97hackbrian/Sensor_Proximidad_difuso/README.md

# Sensor_Proximidad_difuso
IMT-247 INSTRUMENTACIÓN INDUSTRIAL [Par. 1]
[Artículo](Proyecto_SensorDifuso_IEEE.pdf) o 
https://storage.googleapis.com/perritofeliz/Proyecto_SensorDifuso_IEEE.pdf
