97hackbrian/Sensor_Proximidad_difuso/Proyecto_SensorDifuso_IEEE.pdf

## Facultad de Ingeniería Semestre I-2023

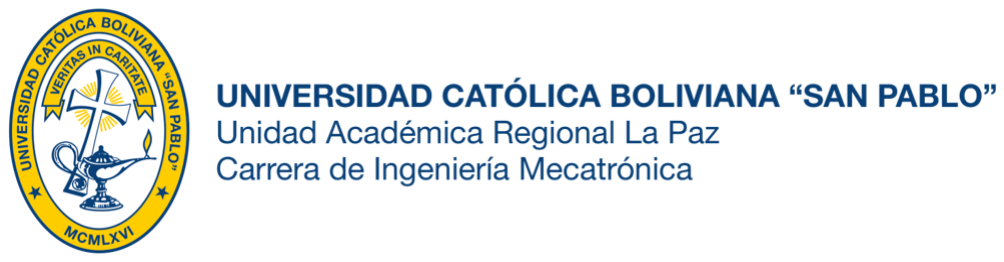
[picture p1: figure]

# UNIVERSIDAD CATÓLICA BOLIVIANA “SAN PABLO” CARRERA DE INGENIERÍA MECATRÓNICA

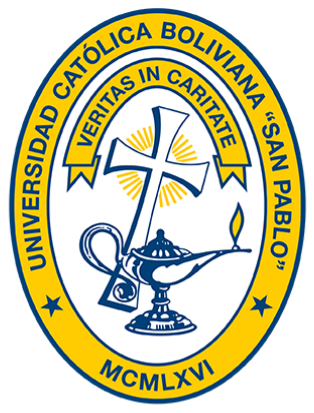
[picture p2: figure]

# SENSOR DE PROXIMIDAD INFRARROJO DIFUSO REFLECTIVO PARA APLICACIONES INDUSTRIALES

## Integrantes:

## Brayan Gerson Durán Toconás

## Alexander Ramiro Mujica Reyanga

## Docente:

## Ing. Freddy Fernando Ferrufino Gutierrez

## Materia:

## Instrumentación Industrial - IMT 247

# La Paz - Bolivia

2023

IMT-247 INSTRUMENTACION INDUSTRIAL [PAR. 1], MAYO 2023 ´ | 1

# Sensor de proximidad infrarrojo difuso reflectivo para aplicaciones industriales

Brayan Duran T. , Miembro, IEEE,UCB & Alexander Mujica R. , Miembro, IEEE,UCB

Abstract—Este informe tiene como objetivo presentar
el diseno, construcci ˜ | on, resultados y conclusiones de un ´
Sensor de proximidad infrarrojo difuso reflectivo para aplicaciones industriales. El informe esta estructurado en ´
torno a los siguientes subtítulos: Introduccion, Descripci ´ | on´
de la variable a medir, Descripcion del principio de ´ funcionamiento, Componentes, Circuito, Diseno del hous- ˜ ing, Terminales, Hoja de datos, Resultados obtenidos,
Conclusiones. Se proporcionara una descripci ´ | on detallada ´
de cada uno de estos aspectos, cubriendo los puntos de
diseno, construcci ˜ | on, resultado y conclusiones del sensor. ´
Se incluiran tambi ´ | en las implicaciones del sensor en las ´
aplicaciones industriales y las posibles mejoras para futuros disenos. ˜
Index | Terms—Automatizacion, | Capacitores | de ´
acoplamiento, Control de procesos, Datos experimentales,
Diseno de circuitos, Dise ˜ | no modular, Electr ˜ | onica, Fiabilidad ´
del diseno, Filtros ˜ | opticos, Infrarrojo, Instrumentaci ´ | on, ´
Leds emisores, Proximidad, Senales digitales, Sensor de ˜ proximidad, Sensor difuso.
I. INTRODUCCION´
L
Os sensores de proximidad infrarrojo difuso reflectivo son dispositivos ampliamente utilizados en aplicaciones industriales. Estos sensores son capaces de detectar objetos cercanos sin necesidad de contacto físico, lo que los convierte en una herramienta valiosa en entornos industriales donde la precision y la velocidad ´ de respuesta son fundamentales. En este informe se
detalla el diseno y construcci ˜ | on de un sensor de proxim- ´
idad infrarrojo difuso reflectivo, así como los resultados obtenidos y las conclusiones derivadas del proyecto.
A continuacion, se describen los puntos que se cubrir ´ | an´
en el informe:
- Descripcion de la variable a medir: En este apartado ´ se describira la variable de proximidad que se ´
medira con el sensor y se explicar ´ | | a su importancia ´
en las aplicaciones industriales.
- Descripcion del principio de funcionamiento: Se de- ´ tallara el principio de funcionamiento del sensor de ´ proximidad infrarrojo difuso reflectivo, incluyendo como detecta la variable de proximidad. ´
- Componentes: Se presentaran los componentes uti- ´ lizados en el diseno del sensor, incluyendo los ˜ sensores infrarrojos, los transistores, los resistores, los capacitores y los conectores.
- Circuito: Se mostrara el esquema del circuito, como ´
tambien el dise ´ | no PCB utilizado en el sensor, ˜
incluyendo una explicacion detallada de su fun- ´ cionamiento.
- Diseno del housing: Se describir ˜ | a el dise ´ | no del ˜
housing del sensor, incluyendo el material utilizado,
las consideraciones de diseno CAD y dise ˜ | | no final ˜
del CAD.
- Terminales: Se presentaran los terminales utilizados ´ en el sensor, incluyendo una descripcion detallada ´ de su funcionamiento.
- Hoja de datos: Se incluira una hoja de datos en ´
tablas que describira las caracter ´ | ísticas tecnicas del ´
sensor, incluyendo su rango de medicion, precisi ´ | on´
y velocidad de respuesta.
- Resultados obtenidos: Se presentaran los resulta- ´ dos obtenidos durante las pruebas del sensor, incluyendo la precision de las mediciones y la esta- ´ bilidad del sensor.
- Conclusiones: Se resumiran los resultados del in- ´ forme y se presentaran las conclusiones finales, ´ incluyendo las implicaciones del sensor en las aplicaciones industriales y las posibles mejoras para futuros disenos. ˜

II. DESCRIPCION DE LA VARIABLE ´

En el marco de este informe, la variable física que abarca el sensor es la distancia, la cual se expresa en unidades de longitud, principalmente en milímetros y centímetros. La distancia es una magnitud escalar en física y matematicas, que se mide en unidades de longi- ´ tud y se puede entender como el camino entre un punto de origen A y un punto de destino B. Este trayecto, por lo general, equivale a la longitud de una recta que une dos puntos, estando en un plano euclídeo. En el contexto industrial, la medicion precisa y confiable de la distancia ´ es fundamental para una amplia variedad de aplicaciones,
como el control de calidad en la produccion, la medici ´ | on´
de posicion de objetos en movimiento, la detecci ´ | on de ´
obstaculos y la seguridad en la maquinaria y los equipos. ´ El sensor de proximidad infrarrojo difuso reflectivo es capaz de detectar la distancia entre un objeto y el sensor mediante la emision de un haz de luz infrarroja, ´ que se refleja en el objeto y se detecta por el sensor, permitiendo así una medicion precisa, directa y confiable ´ de la distancia en aplicaciones industriales.
A. Objetivo
El objetivo de la medicion es establecer una distancia ´ deseada mediante un potenciometro y permitir que el ´ sensor pueda cambiar de estado cuando se alcanza dicha distancia establecida. Por tanto, el proposito principal es ´ la medicion precisa de la distancia previamente config- ´ urada.
B. Medicion de la variable ´
La medicion de la distancia a trav ´ | es del sensor de ´
proximidad infrarrojo difuso reflectivo se realizara me- ´ diante un diodo emisor de luz (LED) y una salida de 24V que se activara cuando un objeto se encuentre dentro de ´ la distancia previamente configurada mediante un po-
tenciometro. Para garantizar la precisi ´ | on de la medici ´ | on, ´
se utilizara un instrumento de medici ´ | on adecuado, como ´
un flexometro, un vernier u otro dispositivo de medici ´ | | on´
de longitud. De esta manera, se podra obtener una ´
medicion precisa de la distancia y se activar ´ | a la salida ´
de 24V en el momento adecuado, lo que permitira su ´ utilizacion en diversas aplicaciones industriales. ´

III. DESCRIPCION DEL PRINCIPIO DE ´

FUNCIONAMIENTO
La descripcion del principio de funcionamiento del ´ sensor de proximidad infrarrojo difuso reflectivo es fundamental para entender su funcionamiento. El sensor opera mediante la reflexion directa de la luz infrarroja, es ´ decir, se requiere de una fuente de luz infrarroja que sea capaz de rebotar en cualquier objeto y que la misma sea detectada por un componente receptor de luz infrarroja. Esta tecnica se basa en el uso de un emisor infrarrojo ´ que emite luz en una direccion, la cual es reflejada por el ´ objeto y recibida por el receptor infrarrojo. La medicion´ de la distancia entre el sensor y el objeto se realiza a traves de la intensidad de la luz infrarroja que es recibida ´ por el componente receptor. Para una mejor comprension´ del tema, se presenta a continuacion un diagrama que ´ ilustra el funcionamiento del sensor infrarrojo difuso reflectivo en cuestion. ´

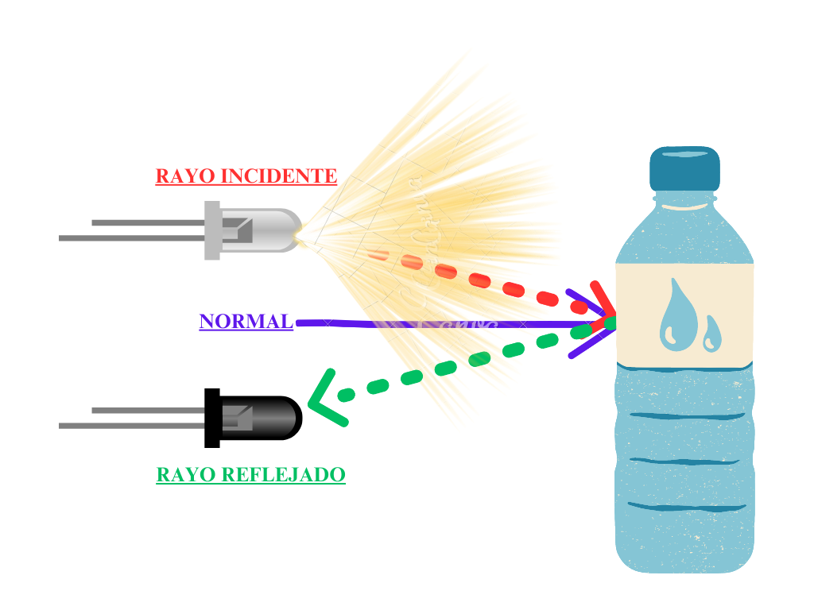
[picture p3: figure]

Fig. 1. Diagrama físico ilustrativo

La imagen previamente presentada ilustra el funcionamiento del sensor de proximidad infrarrojo difuso reflectivo, en el cual el emisor produce una luz que se refleja en el objeto con el mismo angulo del emisor ´ respecto a la normal. Posteriormente, la luz reflejada es recibida por el receptor que se encuentra en la parte inferior del sensor. Es importante mencionar que el angulo de ´
reflexion es igual al ´ | angulo de incidencia, como lo dicta ´
la ley de reflexion de la luz. Este fen ´ | omeno se aprovecha ´
para la deteccion de objetos, ya que la intensidad de ´ la luz recibida por el receptor esta relacionada con la ´ distancia entre ambos y la deteccion. ´
La reflexion de la luz es un fen ´ | omeno f ´ | ísico que se
produce cuando la luz incide sobre una superficie y parte de ella regresa al medio del que provenía.

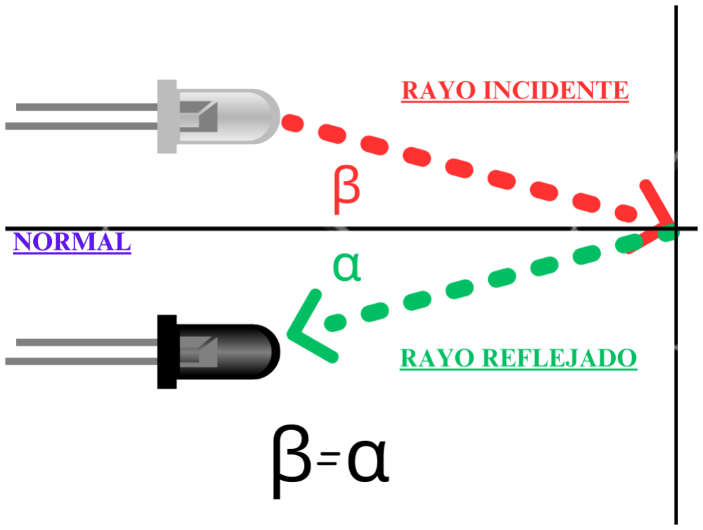
[picture p4: figure]

Fig. 2. Diagrama ilustrativo de la reflexion´

El angulo de incidencia y el ´ | angulo de reflexi ´ | on son ´
iguales y ambos se miden con respecto a la normal a la superficie en el punto de incidencia, como se puede observar en la figura 2. En el caso del sensor de proximidad infrarrojo difuso reflectivo, el principio de funcionamiento se basa en la reflexion directa de la luz ´ infrarroja emitida por el LED. Esta luz es reflejada por el objeto y captada por el receptor del sensor. La intensidad de la luz recibida en el receptor es proporcional a la distancia entre el sensor y el objeto, y es utilizada para determinar si el objeto se encuentra a una distancia previamente configurada. Es importante destacar que el angulo de las luces infrarrojas emitidas y recibidas juega ´ un papel crucial en la medicion precisa de la distancia ´ entre el sensor y el objeto.

IV. COMPONENTES

A continuacion se presentar ´ | a la lista de materiales ´
necesarios para la construccion del sensor de proximidad ´ infrarrojo difuso reflectivo, junto con una explicacion´ detallada de los materiales mas relevantes para su ´ funcionamiento optimo. ´

A. Componentes electronicos ´
A continuacion, se presentar ´ | a una tabla que muestra ´
la cantidad y el codigo de cada uno de los componentes ´ electronicos utilizados en el proyecto. ´
Category | Quantity | Value
Capacitors | 7 | 1nF
Capacitors | 4 | 1uF
Capacitors | 1 | 1uF/2.2nf
Capacitors | 1 | 10nF/0.1uf
Capacitors | 1 | 1nF/op
Capacitors | 1 | 0.1uF
Capacitors | 2 | 68nF
Capacitors | 1 | 2.2nF
Capacitors | 1 | 180pF
Capacitors | 1 | 4.7uF
Resistors | 1 | 1.6k/783
Resistors | 4 | 1k
Resistors | 1 | 1M/op
Resistors | 1 | 10k
Resistors | 1 | 100/330
Resistors | 1 | 470
Resistors | 2 | 1M
Resistors | 1 | 2k/3k
Resistors | 3 | 100
Resistors | 1 | 330
Resistors | 1 | 75k
Resistors | 1 | 20k
Resistors | 1 | 1k/560k
Resistors | 1 | 15k
Resistors | 1 | 8.2k
Resistors | 1 | 8.2k/op
Resistors | 1 | 680k/op
Resistors | 1 | 100/22k
Resistors | 1 | 10k/1k
Resistors | 2 | 680
Integrated Circuits | 1 | NE555
Integrated Circuits | 1 | PT204-6B
Integrated Circuits | 1 | LM741
Integrated Circuits | 1 | LM358N
Integrated Circuits | 1 | PC817
Integrated Circuits | 1 | LM317T
Transistors | 1 | 2N3904
Diodes | 3 | LED
Diodes | 2 | LED/op
Diodes | 2 | 1N4007
IR DIODES | 3 | IRLED
Conector | 1 | 24V
Conector | 1 | Q1
Conector | 1 | Q2
Conector | 1 | 0V
ResVariable | 1 | 100K
Switch | 1 | SW
TABLE I
TABLA DE COMPONENTES ELECTRONICOS ´

Anteriormente, se muestra la tabla de componentes electronicos en ´ la que se detallan la cantidad y el codigo de cada uno. Cabe ´ destacar que algunos componentes se encuentran clasificados como opcionales (OP), lo que indica que pueden ser utilizados para
obtener una senal diferente. Adem ˜ | as, en algunos casos, se presentan ´
dos valores para un mismo componente, y se recomienda utilizar el primer valor para obtener una senal ˜ optima. ´

El componente mas importante para el funcionamiento ´ del sensor es el receptor infrarrojo, ya que sera el ´ encargado de detectar la variacion en el diferencial de ´ potencial a medida que el objeto se aleje o se acerque. Ademas, el emisor o led infrarrojo es otro componente ´ esencial, ya que sera la fuente de luz infrarroja necesaria ´
para el proceso de reflexion y detecci ´ | on. Ambos com- ´
ponentes son cruciales para el correcto funcionamiento del sensor de proximidad infrarrojo difuso reflectivo.
B. Componentes físicos
A continuacion, se presentar ´ | a una lista de los materi- ´
ales físicos necesarios para la construccion del sensor de ´ proximidad infrarrojo difuso reflectivo para aplicaciones industriales.
- Impresion 3D 25 ´ | % de relleno (3 piezas)
- Tornillos y tuercas de 4mm de diametro y 20mm de largo (10)
- Arandelas de 4mm-10mm o tornillos de 4mm con cabeza en T (4)
Se debe enfatizar que para la realizacion del prototipo ´ es crucial la correcta fabricacion de la carcasa mediante ´
impresion 3D. Esta debe tener un acabado ´ | optimo y las ´
dimensiones exactas especificadas en el diseno CAD. ˜
Ademas, se recomienda que la carcasa tenga un m ´ | ínimo
del 20% de relleno para garantizar una adecuada resisten-cia y durabilidad del prototipo. Es importante tener en
cuenta que la calidad y precision de la impresi ´ | on 3D ´
puede afectar significativamente el funcionamiento del dispositivo y, por lo tanto, se deben tomar medidas para asegurar que se realice una impresion de alta calidad. ´
V. CIRCUITO
Rescrito: En esta seccion se presentar ´ | a una explicaci ´ | on´
detallada del diseno esquem ˜ | atico del circuito, as ´ | í como
del diseno del PCB. Tambi ˜ | en se mencionar ´ | an algunas ´
normativas que se consideraron para el diseno, tanto en ˜ el diagrama como en la disposicion de los componentes ´ en la placa.
A. Diagrama electronico ´
Para el diseno del circuito se sigui ˜ | o un enfoque ´
modular, dividiendolo en diferentes bloques funcionales. ´ Cada uno de estos bloques se disenõ en el software ´
de diseno de esquemas electr ˜ | onicos PROTEUS-8.12, ´
utilizando símbolos y conexiones estandarizados. Se
utilizo el modelo jer ´ | arquico para organizar el circuito ´
en diferentes niveles de abstraccion, lo que permiti ´ | o una ´
mejor visualizacion y comprensi ´ | on del circuito. ´
A continuacion se presentar ´ | a el esquema electr ´ | onico, ´
el cual representa la distribucion y conexi ´ | on de los ´
componentes electronicos utilizados en el dise ´ | | no del ˜
circuito. Este esquema es fundamental para entender la funcionalidad y operacion del circuito, y para su ´ posterior implementacion en la tarjeta PCB: ´

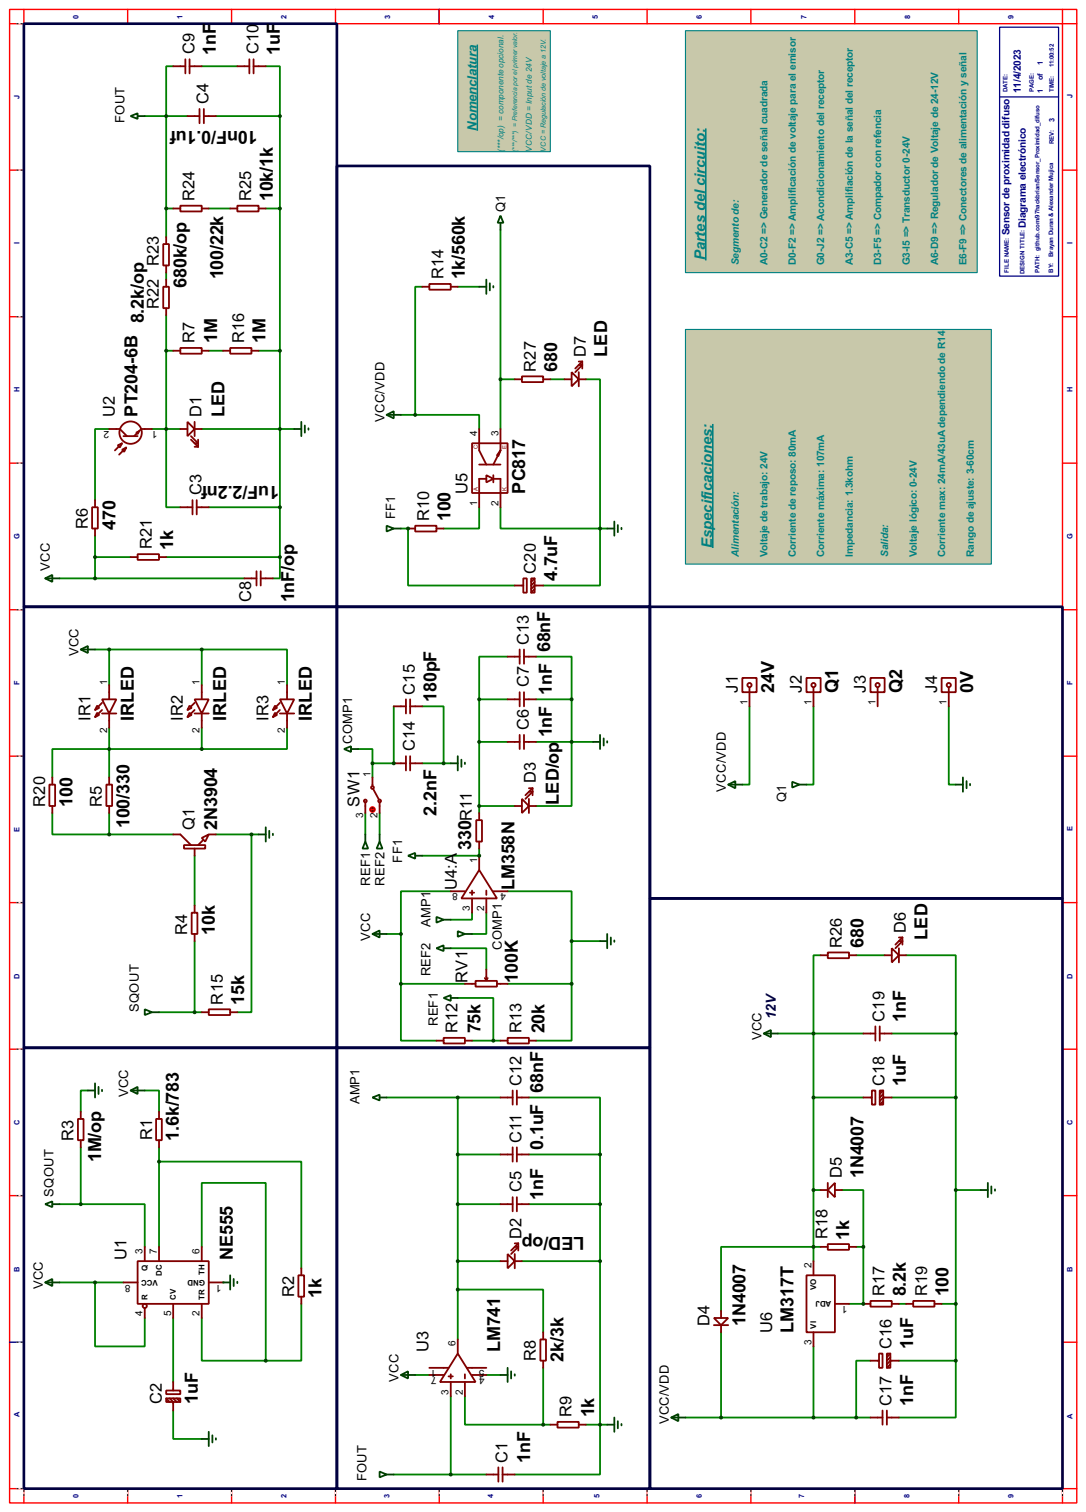
[picture p5: page 5]

(***/***) = Preferencia por el primer valor. V

Brayan Duran & Alexander Mujica github.com/97hackbrian/Sensor_Proximidad_difuso PATH: 1 of 1 REV: 3 TIME: 11:00:52 DESIGN TITLE:Dia

1) Funcionamiento: A continuacion, se detallar ´ | a cada ´
parte del circuito y su funcion: ´

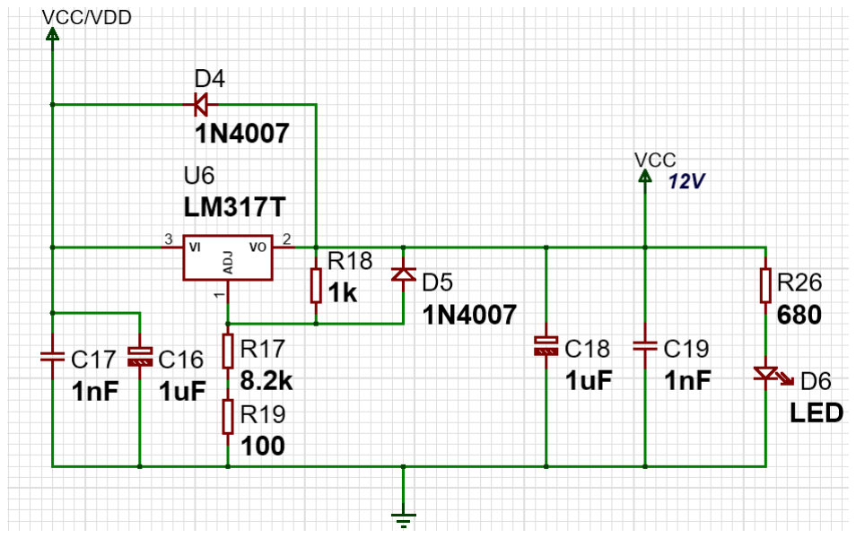
[picture p6: figure]

Fig. 3. Regulacion de voltaje 24-12V ´
Donde VCC/VDD es un voltaje de 24V y VCC es una salida regulada a 12V.
Esta seccion del circuito tiene como funci ´ | on regular ´
el voltaje que se suministra a la seccion anal ´ | ogica ´
del circuito, lo cual es esencial para su correcto funcionamiento. Cuando se alimenta esta seccion del cir- ´ cuito con 24V, el LED D6 se enciende con su maximo ´ brillo, lo que indica que esta funcionando correctamente. ´

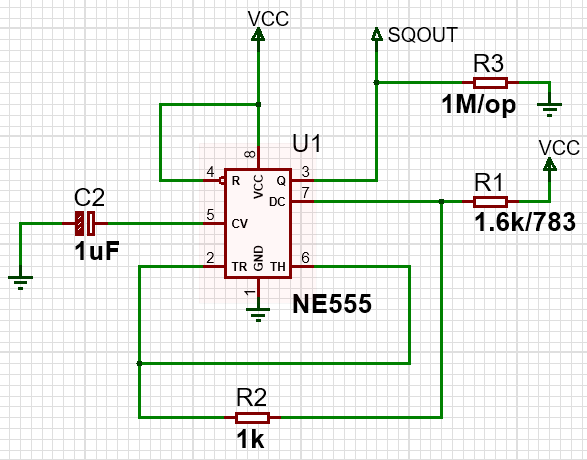
[picture p7: figure]

Fig. 4. Generacion de ondas cuadradas ´
Donde el NE555 es el encargado de generar senales ˜ periodicas. Se alimenta con 12V por VCC y la salida ´ cuadrada es SQOUT.
Esta seccion del circuito tiene la funci ´ | on de generar ´
una senal cuadrada con un ciclo de trabajo y frecuencia ˜ definidos a traves del circuito astable del NE555. Para ´ establecer las características de la senal, se proponen las ˜ siguientes ecuaciones:

f =

1.44
(R1 + 2 · R2) · C

(1)

Duty Cycle =

R1 + R2
| R1 + 2 · R2

(2)

Sustituyendo los valores dados, se tiene:

f =

1.44
(1.6kΩ + 2 · 1kΩ) · 1µF

≈ 446.4 Hz (3)

Duty Cycle =

1.6kΩ + 1kΩ
1.6kΩ + 2 · 1kΩ

= 0.6 (4)

Por lo tanto, la frecuencia es de aproximadamente 446.4 Hz y el ciclo de trabajo es de 0.6. El proposito de ´
esta senal es emitir una se ˜ | nal con estas caracter ˜ | ísticas y
posteriormente recibirla para verificar su efectividad.

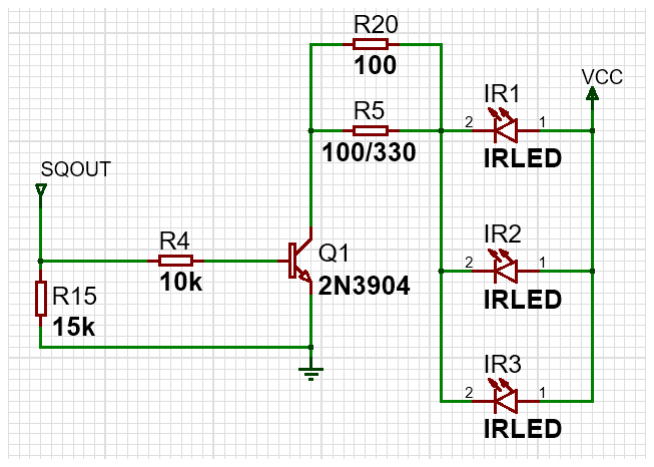
[picture p8: figure]

Fig. 5. Emision de la luz infrarroja ´
Donde el 2N3904 es el amplificador de corriente para los leds infrarrojos IR1,IR2,IR3.

En esta seccion del circuito, se utiliza un circuito ´ colector comun con un transistor BJT 2N3904 para ´ amplificar la corriente que se suministra a los LEDs infrarrojos y emitir luz infrarroja. La corriente que circula por los LEDs se puede calcular utilizando las siguientes ecuaciones:

IC = βIB | (5)
VR1 = VCC − VBE − VR2 | (6)

IB =

VR1
R1

(7)

ILED = IC = β

VR1
R1

(8)

Sustituyendo los valores dados, se tiene:

VR1 = 12V − 0.65V − 100Ω · 50mA ≈ 6.35V (9)

IB =

6.35V
10kΩ
≈ 635uA | (10)
IC = βIB = 100 · 635uA mA = 63.5mA | (11)

Por lo tanto, la corriente de la base es IB ≈ 635uA y la corriente para los LEDs es ILED = IC ≈ 63.5mA.

La luz emitida por los LEDs se activa mediante la senal cuadrada generada por el circuito anteriormente ˜ mencionado, la cual se aplica a la base del transistor.

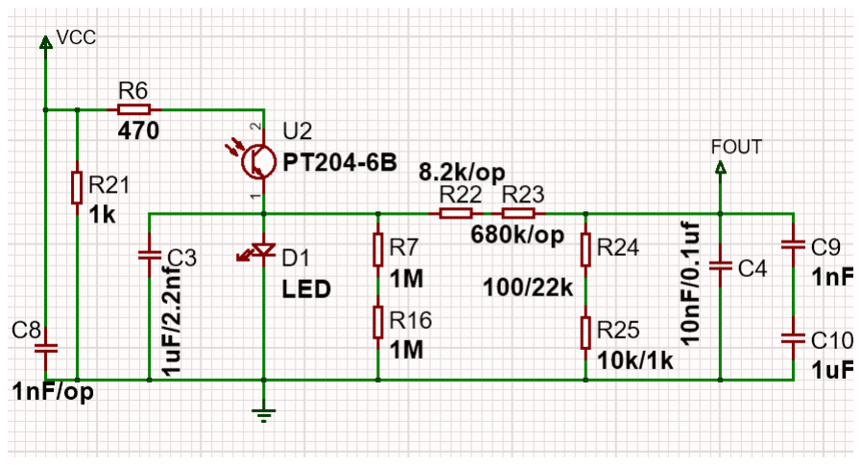
[picture p9: figure]

Fig. 6. Receptor de la luz infrarroja
Donde el PT 204-6B es el componente encargado de recibir la luz infrarroja, generar un diferencial de potencial entre sus pines emisor y receptor.

En esta parte del circuito se utiliza un fototransistor PT204-6B para procesar la senal. Las resistencias en ˜ el colector y el emisor se calculan con las siguientes ecuaciones:

VCE = VCC − IC · RC | (12)
VRE = IC · RE | (13)

remplazando,

Rc = R6, Re = (R7 + R16)||(R25 + R24) :

VCE = 12V − 20mA · 470Ω = 2.6V (14)

Por lo tanto, VCE es de 2.6V.En otras palabras, la caída de voltaje entre el colector y el emisor del circuito
sera de un m ´ | aximo de 2.6V cuando la luz del emisor sea ´
detectada por el receptor. En resumen, el circuito adapta la senal del receptor para que solo reciba la ganancia ˜ adecuada correspondiente al LED infrarrojo, de modo que la luz externa tenga un efecto mínimo en la senal. ˜

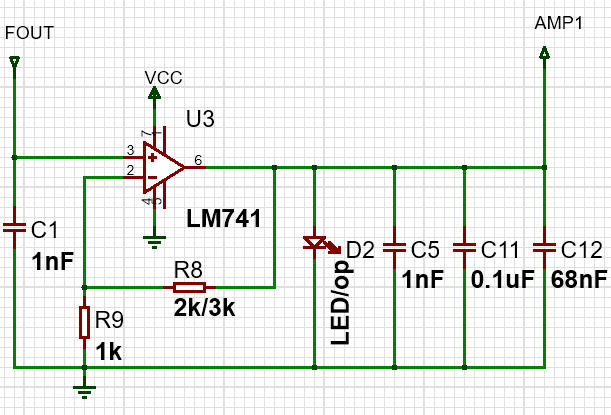
[picture p10: figure]

Fig. 7. Amplificacion de la se ´ | nal ˜
Donde el amplificador operacional LM741 se encarga de amplificar la senal del receptor al doble. ˜

Para esta parte, la senal del receptor anteriormente ˜ vista se amplificara mediante este circuito amplificador ´ no inversor que tiene la siguiente ecuacion: ´

Vout = Vin ·

1 +

R1
R2
(15)

Remplazando con los siguientes datos R1 = 1kΩ = R9 y R2 = 2kΩ = R8 se obtiene:

Vout = Vin ·

1 +

1kΩ
2kΩ
= 2Vin | (16)

Teniendo una ganancia de 2 veces el voltaje de entrada.
Es decir, que la salida maxima 2.6V ahora tendr ´ | a un ´
valor de 5.2V.
En resumen, este circuito tiene el proposito de amplificar ´ la senal del receptor para que posteriormente pueda ser ˜ tratada con mayor fiabilidad.

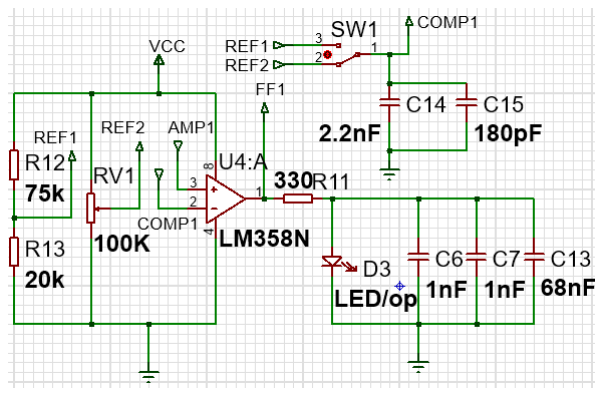
[picture p11: figure]

Fig. 8. Comparador de senal ˜
Donde el LM358N en sus puertos ”A” funcionan como un comparador de nivel alto

En este apartado, se comparara la se ´ nal amplificada ˜ con un valor fijo de tension o un valor regulable mediante ´
un potenciometro. Enfoc ´ | andonos en el valor regulable, ´
este consiste practicamente en un re ´ | ostato que hace caer ´

la tension y esta misma entra al amplificador operacional ´
para ser comparada. La formula para la ca ´ | ída de tension´
por un potenciometro re ´ | ostato de 100K es la siguiente: ´

VR =

R2
R1 + R2
- Vin | (17)
Donde VR es la caída de tension en el potenci ´ | ometro, ´
Vin es la tension de entrada y ´ | R1 y R2 son las resisten-
cias del potenciometro. ´
En resumen, este paso consiste en utilizar un po-
tenciometro para regular la tensi ´ | on que entra al AMP op ´
y así poder compararla con la senal amplificada. De esta ˜ forma, se puede regular la distancia a la que el sensor conmuta al detectar un objeto.

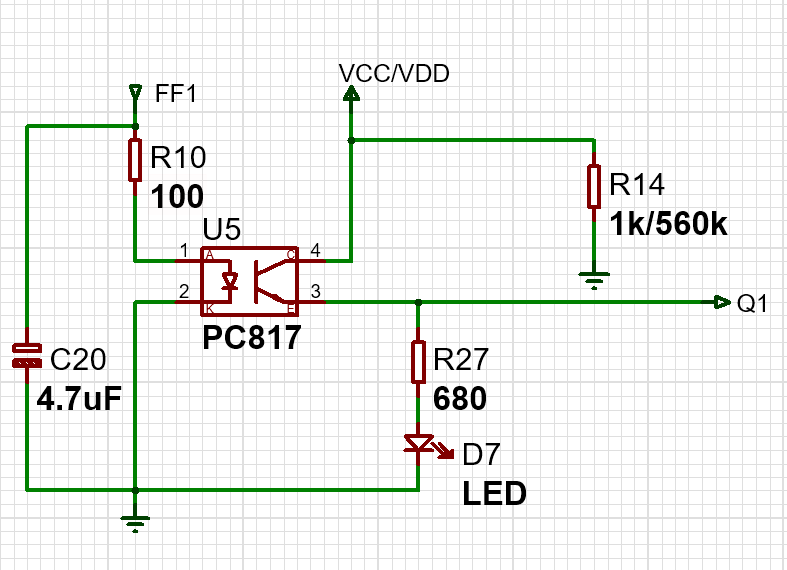
[picture p12: figure]

Fig. 9. Opto acoplamiento de la senal ˜
Donde el PC 817 se encarga de disparar una senal de ˜ 24V con una senal de 12V del anterior circuito. ˜

Este circuito tiene como proposito aislar la fuente de ´ alimentacion de 12V de la fuente de 24V. Para lograr ´
esto, su funcion es generar una se ´ | nal de salida que ˜
puede ser de 0V o 24V. Ademas, se encarga de limitar ´ la corriente de salida para proteger el circuito en caso de una sobrecarga o cortocircuito en la salida de senal ˜ Q1.
2) Consideraciones para el diseno Esquem ˜ | atico: ´
Las consideraciones que se tomaron para el disenõ esquematico, fueron las siguientes: ´
- Disenar un esquema modular y por partes para la ˜
facil abstracci ´ | on. ´
- Escoger materiales de facil acceso en el mercado. ´
- Dar opciones de valores y componentes para diferentes comportamientos del circuito.
- Dotar de capacitores de acoplamiento para eliminar los picos de voltaje en algunas partes del circuito.
B. Diseno PCB ˜
En cuanto al diseno del PCB, se utiliz ˜ | o el software ´
de diseno de PCB para realizar la disposici ˜ | on de los ´

componentes y la traza de las pistas en la placa. Se tuvo en cuenta la disposicion de los componentes en ´ el esquema para minimizar la longitud de las pistas y evitar interferencias entre ellas. Tambien se tuvo en ´ cuenta la disposicion de los componentes para facilitar ´ la soldadura y el montaje en la placa.

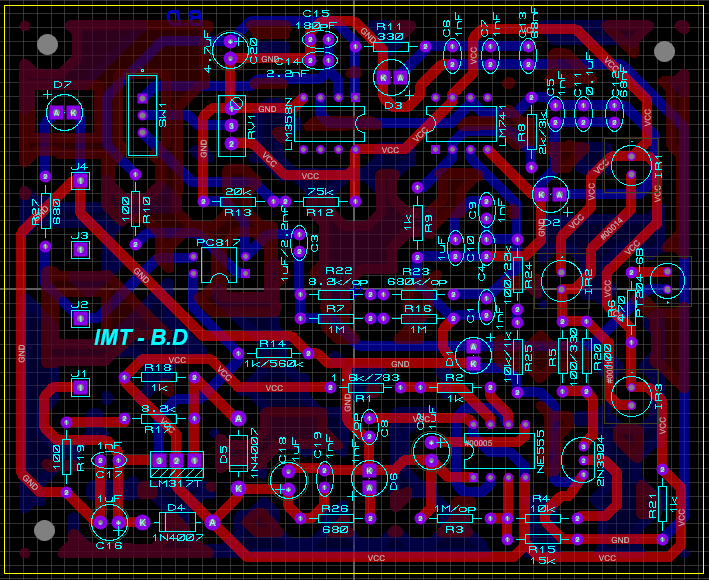
[picture p13: figure]

Fig. 10. PCB

1) Normativas PCB IPC2221B: Para el diseno de la ˜ placa se consideraron algunas normativas y estandares, ´ como la separacion m ´ ínima entre pistas y la separacion entre los componentes para evitar cortocircuitos. ´
Tambien se tom ´ | o en cuenta la anchura de las pistas ´
para garantizar la capacidad de corriente adecuada. Todo esto se realizo para garantizar la seguridad y el correcto ´ funcionamiento del circuito.

VI. DISENO DEL HOUSING ˜

Para el diseno del housing en la parte del emisor y ˜ receptor se propuso un diseno similar al ilustrado en ˜ la figura 1, sin embargo, se decidio utilizar dos leds ´ emisores en lugar de uno solo para mejorar el rango de funcionamiento y la fiabilidad en la conmutacion del ´ circuito. La idea detras de esto es que, al utilizar dos leds ´ en lugar de uno, se logra una mayor intensidad luminosa
en el area de detecci ´ | on, lo que aumenta la probabilidad ´
de detectar objetos en diferentes condiciones de ilumi-
nacion. A continuaci ´ | on se muestra la pieza donde se ´
ubica el emisor y receptor.

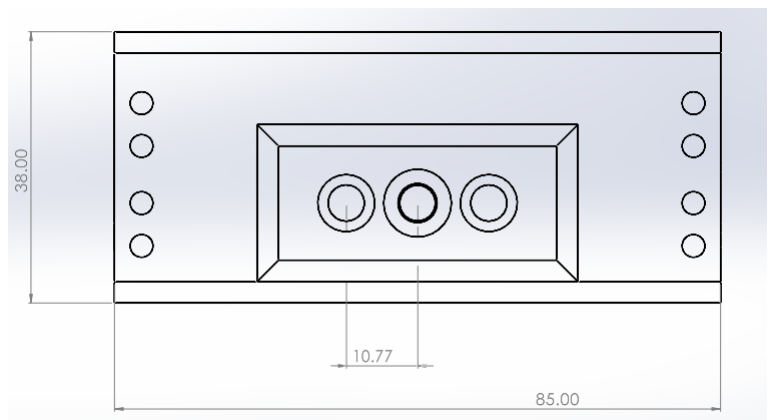
[picture p14: figure]

Fig. 11. Pieza del emisor y receptor
Donde los 3 orificios corresponden a los emisores y receptor. Teniendo dos emisores a los costados y el receptor al centro.

Por otra parte, se dispone de una tapa superior e inferior que, en conjunto con la tapa de los emisores y receptores, conforman el housing del sensor. Estas piezas estan sujetas mediante tornillos para asegurar la ´ estabilidad del conjunto.

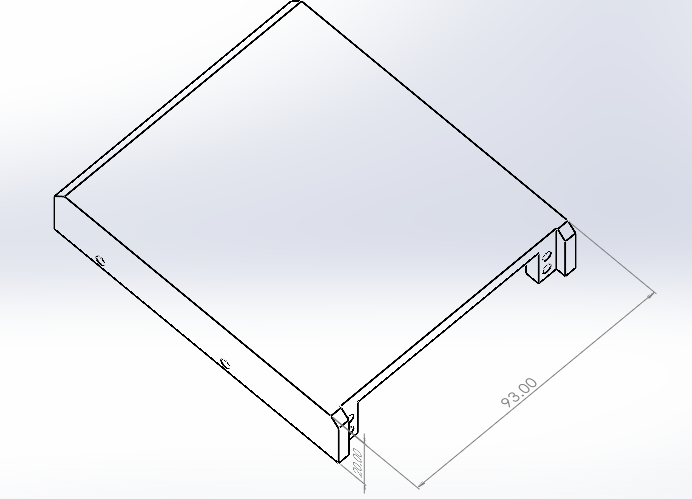
[picture p15: figure]

Fig. 12. Pieza de la tapa superior

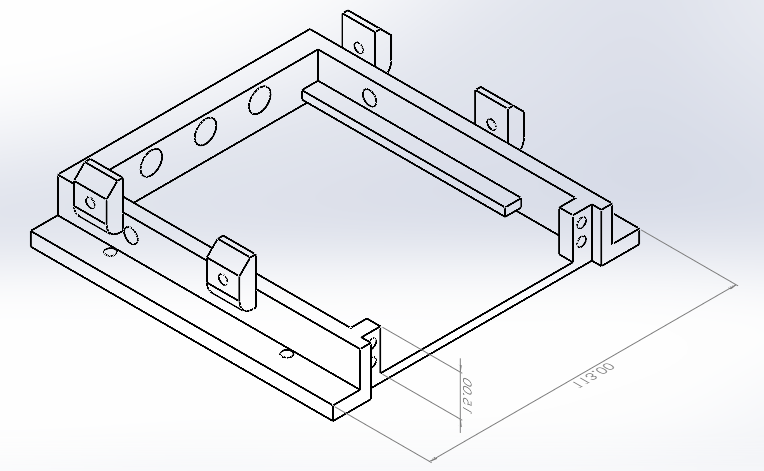
[picture p16: figure]

Fig. 13. Pieza de la tapa inferior

La union de todas las piezas da como resultado el ´
housing completo. A continuacion se presenta el dise ´ | nõ
final del housing.

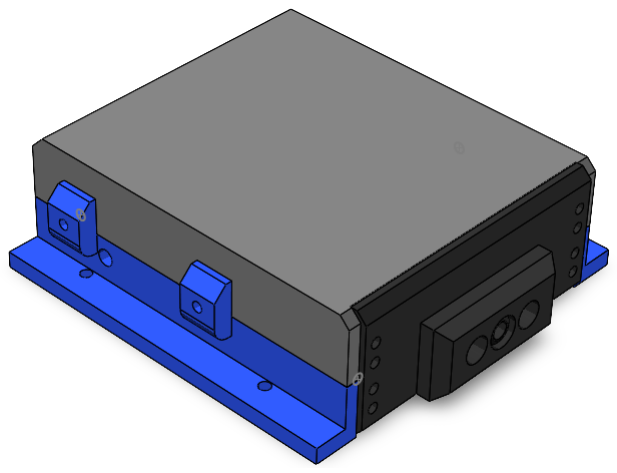
[picture p17: figure]

Fig. 14. Ensamble final

VII. TERMINALES
A continuacion, se presentar ´ | a una imagen que muestra ´
las terminales y, ademas, se proporcionar ´ | an sus especi- ´
ficaciones mediante una tabla para mayor claridad y facilidad de entendimiento.

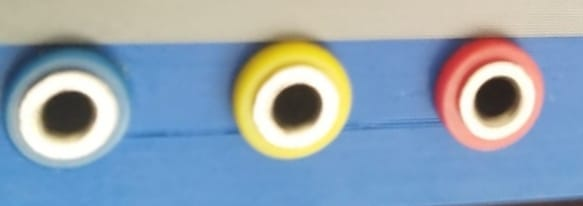
[picture p18: figure]

Fig. 15. Terminales
En la imagen se pueden observar 3 conectores que corresponde a: 0V,Senal-Q1,24V; Respectivamente. ˜
Terminales | Valor | Unidades
Alimentacion´ | 24 | V
Corriente de alimentacion en reposo ´ | 250 | mA
Corriente de alimentacion en conmutaci ´ on´ | 300 | mA
Salida Q1 | 0-22.5 | V
Corriente maxima Q1 ´ | 36 | mA

VIII. HOJA DE DATOS
A continuacion, se presentan las mediciones obtenidas ´ del presente sensor optico difuso. ´
A. Rango
Para obtener el rango del sensor, se realizo 2 medi- ´ ciones, los cuales son el valor mínimo posible, y el valor maximo que puede llegar a medir el presente sensor. ´
Ademas de obtener las medidas del m ´ | aximas y ´
mínimas del sensor con el material de color blanco, se realizaron pruebas con materiales de distintos colores, los cuales son:

Rango Mínimo [cm] | Rango Maximo [cm] ´
5.5 | 145
TABLE II
VALORES MAXIMOS Y M ´ | ÍNIMOS
La tabla 2 muestra los valores maximos y m ´ | ínimos registrados por el
sensor. Estos valores fueron obtenidos utilizando una hoja de color blanco como fondo para minimizar cualquier influencia externa en la medicion. ´
Color | Rango Mínimo[cm] | Rango Maximo[cm] ´
Negro | 6.2 | 84
Morado | 7.5 | 120
Carton´ | 6 | 101
TABLE III
VALORES MAXIMOS Y M ´ | ÍNIMOS CON DISTINTOS COLORES
La tabla 3 muestra los valores maximos y m ´ | ínimos registrados por el
sensor. Estos valores fueron obtenidos utilizando materiales de distintos colores.
B. Resolucion´

Debido a que el sensor presenta una salida digital, este no presenta una unidad de medida mínima, para la
obtencion de la resoluci ´ | on. ´
C. Sensibilidad
A continuacion se presentar ´ | a los datos para la ob- ´
tencion de la sensibilidad del sensor. ´
Tension[V] ´ | Distancia[cm] | Sensibilidad[cm/V]
6 | 9 | 1.50
6 | 10 | 1.67
6 | 9.5 | 1.58
6 | 8.8 | 1.47
| Promedio: | 1.55
TABLE IV
SENSIBILIDAD DEL SENSOR

La Tabla 3 presenta los datos obtenidos del sensor, que incluyen la
tension en el potenci ´ | ometro y la distancia al material de color ´
blanco. Estos datos se utilizaron para determinar la sensibilidad del sensor. Finalmente, se calculo el promedio de estos datos para ´ obtener un valor representativo de la sensibilidad del sensor
D. Salida
A continuacion se presentar ´ | a los datos de salida que ´
posee el sensor optico difuso, esto obten ´ | ído directamente
con mediciones del sensor.
Corriente [mA] | Voltaje [V]
36 | 22.9
TABLE V
SALIDA DEL SENSOR

La tabla 4 presenta los valores de tension y corriente de salida del ´ sensor, expresados en sus respectivas unidades.

E. Error
Para la obtencion del error, se midi ´ | o el valor de tensi ´ | on´
de salida del sensor, y se comparo con el valor te ´ | orico, ´
el cual es el valor del voltaje que se usa en la industria ”24V”.
Tension te ´ orica[V] ´ | Tension real[V] ´ | Error [porcentaje]
24 | 22.9 | 4.58
TABLE VI
ERROR DEL SENSOR
La Tabla 5 presenta los valores teoricos y experimentales de tensi ´ | on´
del sensor. Estos valores se utilizaron para así poder calcular el error del sensor.
F. Condiciones de trabajo
Las condiciones de trabajo que presenta el sensor para un funcionamiento optimo, es el siguiente: ´
Temperatura [C] | 20
Tension [V] ´ | 24
Frecuencia de muestreo [Hz] | 446
Tamano [ ˜ cm³ ] | 12 - 12 - 4
TABLE VII
CONDICIONES DE TRABAJO
La Tabla 6 presenta las condiciones optimas de operaci ´ | on para el ´
sensor, incluyendo las medidas del mismo. Estas condiciones son cruciales para el correcto funcionamiento del sensor y deben ser cuidadosamente observadas. Asegurarse de que se cumplan estas
condiciones mejorara la precisi ´ | on y la fiabilidad de los resultados ´
obtenidos con el sensor.
G. Hiteresis ´
Para obtener la histeresis del sensor, se realiz ´ | o una ´
serie de mediciones con materiales de distintos colores, tal como se ve en la siguiente tabla.
Color | Conexion´ [cm] | Desconexion´ [cm] | Histeresis[%] ´
Blanco | 125 | 129 | 2.76
Negro | 80 | 82 | 1.38
Morado | 113 | 114 | 0.69
Carton´ | 102 | 102.5 | 0.34
| | Histeresis: ´ | 1.29
TABLE VIII
HISTERESIS ´

La tabla 7 muestra los valores de histeresis del sensor para ´ diferentes colores probados, así como la media de los valores obtenidos previamente

IX. RESULTADOS OBTENIDOS
En esta seccion del informe, se presentar ´ | a el pro- ´
ducto final en una fotografía y se proporcionara una ´ explicacion detallada sobre su funcionamiento real. El ´ producto final consiste en el sensor optico de distancia ´ desarrollado a lo largo de este proyecto. Como se puede observar en la figura 16, el sensor consta de dos partes principales: el emisor y el receptor. El emisor está compuesto por dos LEDs infrarrojos, mientras que el receptor tiene un fototransistor.
La operacion del sensor ´ | optico de distancia es bastante ´
sencilla: el emisor emite una senal infrarroja, que se ˜ refleja en el objeto a detectar y llega al receptor. Si el
objeto esta lo suficientemente cerca del sensor, la se ´ | nal ˜
reflejada sera lo suficientemente fuerte como para hacer ´ que el fototransistor conduzca. En este caso, se detectará
una senal de salida en el circuito electr ˜ | onico del sensor, ´
que puede utilizarse para activar otro dispositivo, como una alarma, un motor, un rele, etc. ´
Es importante destacar que este sensor optico de ´ distancia ha sido disenado teniendo en cuenta diversas ˜
consideraciones tecnicas y de dise ´ | no, incluyendo la ˜
seleccion de componentes de alta calidad, la imple- ´
mentacion de un esquema modular y la inclusi ´ | on de ´
capacitores de acoplamiento para evitar picos de voltaje
en el circuito. Ademas, el dise ´ | no del housing permite un ˜
facil acceso a las terminales del sensor y cuenta con una ´ tapa superior e inferior que se sujetan mediante tornillos para mayor seguridad.
En conclusion, el sensor ´ | optico de distancia pre- ´
sentado en este proyecto es un dispositivo altamente confiable y preciso que puede ser utilizado en una amplia variedad de aplicaciones, desde sistemas de seguridad hasta robots y dispositivos de automatizacion industrial. ´

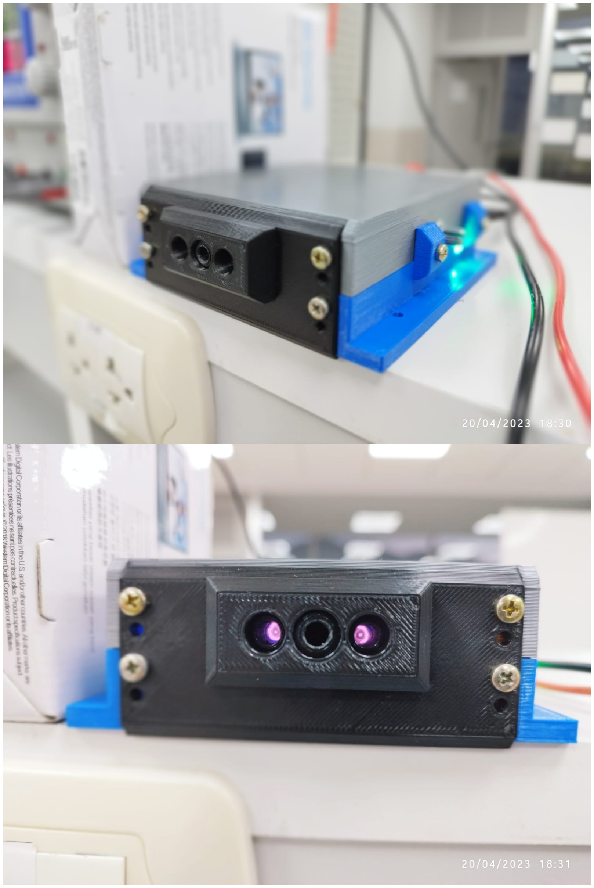
[picture p19: figure]

Fig. 16. Sensor optico de distancia: producto final. ´

X. CONCLUSION´

Luego de completar el proyecto de diseno y con- ˜ struccion del sensor de proximidad, se concluye que se ´ logro cumplir con los objetivos planteados. El sensor ´ disenado es capaz de detectar objetos en un rango de ˜ 5.5cm a 145cm y proporciona una senal digital que es ˜
util para su integraci ´ | on en sistemas de control automa- ´
tizados.
El proceso de diseno se enfoc ˜ | o en utilizar componentes ´
de facil acceso en el mercado y se busc ´ | o proporcionar ´
opciones para diferentes comportamientos del circuito. Se tomaron en cuenta consideraciones importantes como la necesidad de aislar la fuente de 12V y la de 24V para evitar problemas de corriente, y se incluyeron capacitores de acoplamiento para eliminar los picos de voltaje en algunas partes del circuito.
Ademas, se pudo comprobar la funcionalidad del sensor ´ mediante las pruebas realizadas y los datos registrados en las tablas, lo que demuestra que el diseno es confiable ˜ y funciona correctamente.
Por lo tanto, se considera que el proyecto fue exitoso y se cumplio con los objetivos planteados. Este sensor de ´ proximidad puede ser utilizado en diversos sistemas de
control y automatizacion, y su dise ´ | no modular permite ˜
una facil adaptaci ´ | on y personalizaci ´ | on seg ´ | un las necesi- ´
dades del usuario.

XI. RECOMENDACIONES
Despues de haber completado el proyecto del sen- ´ sor de proximidad, se recomienda que en futuras implementaciones se considere aumentar la potencia de los LED emisores para mejorar el alcance del sensor. Asimismo, se sugiere considerar la utilizacion de tres ´ LED emisores en lugar de dos para lograr un rango de
deteccion m ´ | as amplio. Adem ´ | as, se recomienda investigar ´
la posibilidad de utilizar filtros opticos para mejorar ´ la sensibilidad y precision del sensor en condiciones ´
de iluminacion ambiental variable. Tambi ´ | en ser ´ | ía util ´
explorar diferentes materiales para el housing del sensor para mejorar la proteccion contra el polvo y la humedad. ´ En conclusion, se espera que estas recomendaciones sean ´ consideradas en futuras implementaciones del sensor de proximidad con el fin de mejorar su rendimiento y aplicabilidad en diferentes contextos y aplicaciones.

APPENDIX A

EVIDENCIA DE TRABAJO

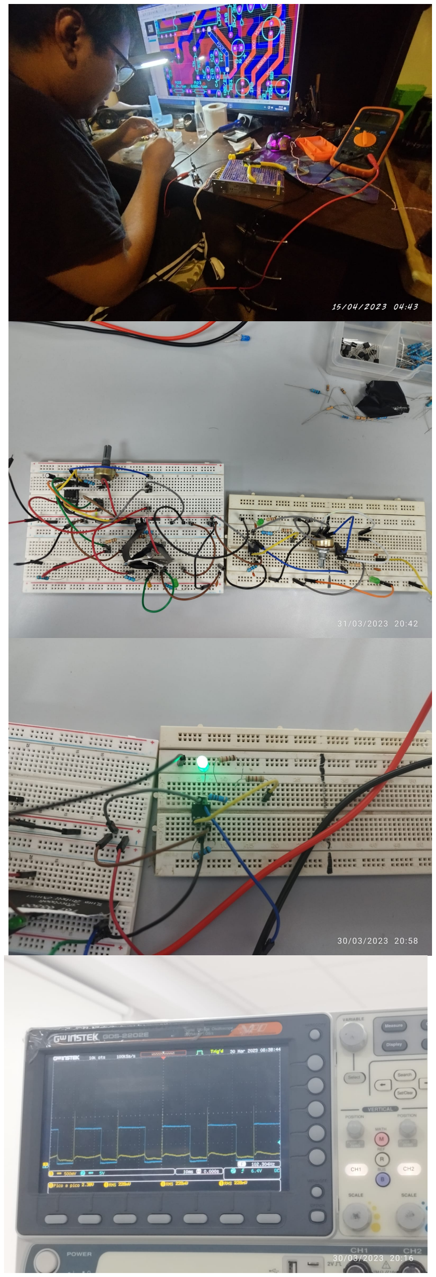
[picture p20: figure]
