97hackbrian/Sensor_Proximidad_difuso/Case/Ensamblaje2FINAL.SLDASM

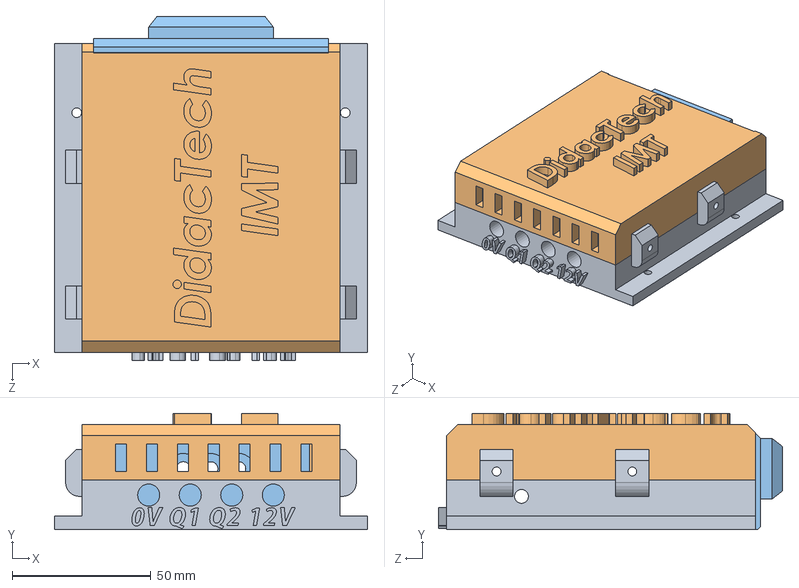
[picture p21: CAD file, 2023-09-25]
Case/Ensamblaje2FINAL.SLDASM
113.0 x 42.0 x 124.3 mm
Base
tapa
tapaemisor
