97hackbrian/Sensor_Proximidad_difuso/Case/Base.SLDPRT

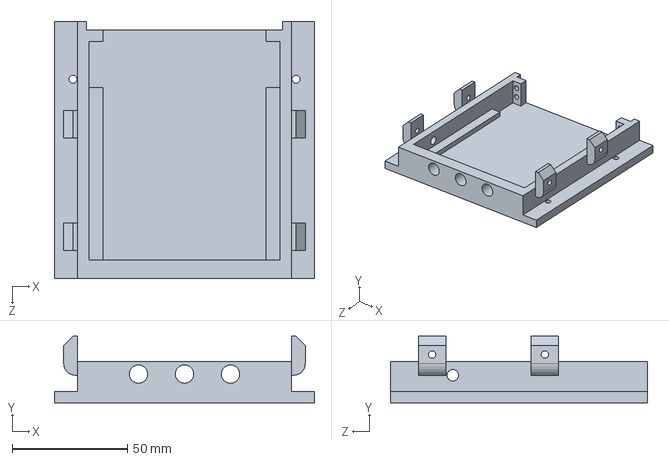
[picture p22: CAD file, 2023-09-25]
Case/Base.SLDPRT
113.0 x 29.0 x 111.5 mm
