97hackbrian/Sensor_Proximidad_difuso/Case/tapaemisor.SLDPRT

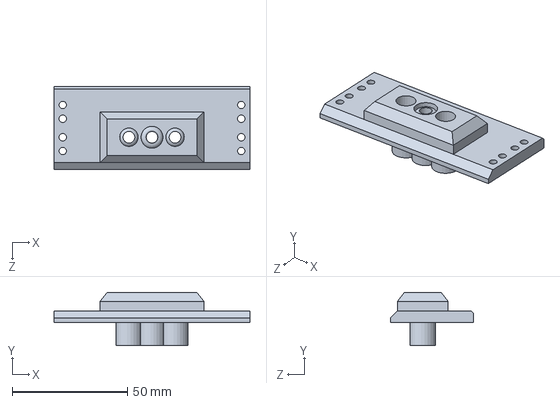
[picture p23: CAD file, 2023-09-25]
Case/tapaemisor.SLDPRT
85.0 x 23.0 x 36.0 mm
