97hackbrian/Sensor_Proximidad_difuso/Case/tapa.SLDPRT

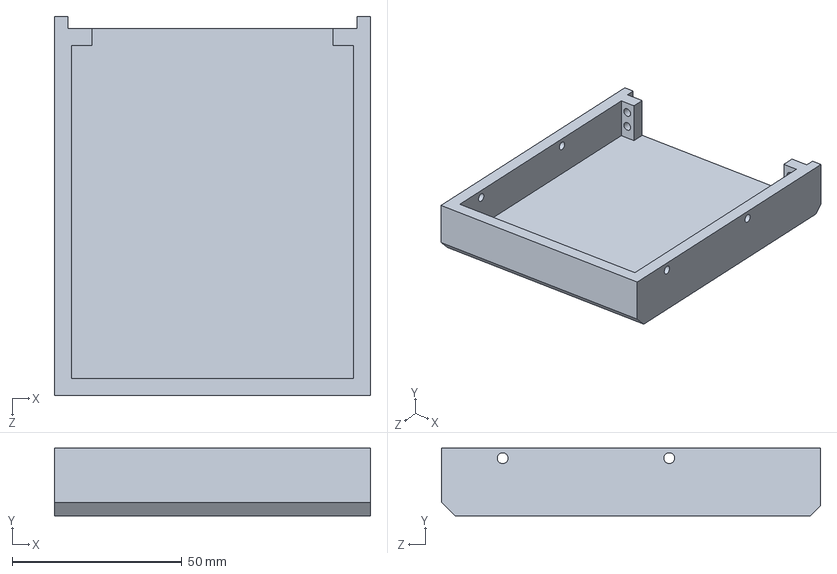
[picture p24: CAD file, 2023-09-25]
Case/tapa.SLDPRT
93.0 x 20.0 x 111.5 mm
