97hackbrian/Sensor_Proximidad_difuso/(list of files, cad)

Other CAD files:
Case/Base.STL
Case/tapa.STL
Case/tapaemisor.STL
