97hackbrian/Sensor_Proximidad_difuso/Diagrama_PCB_sensor_difuso.PDF

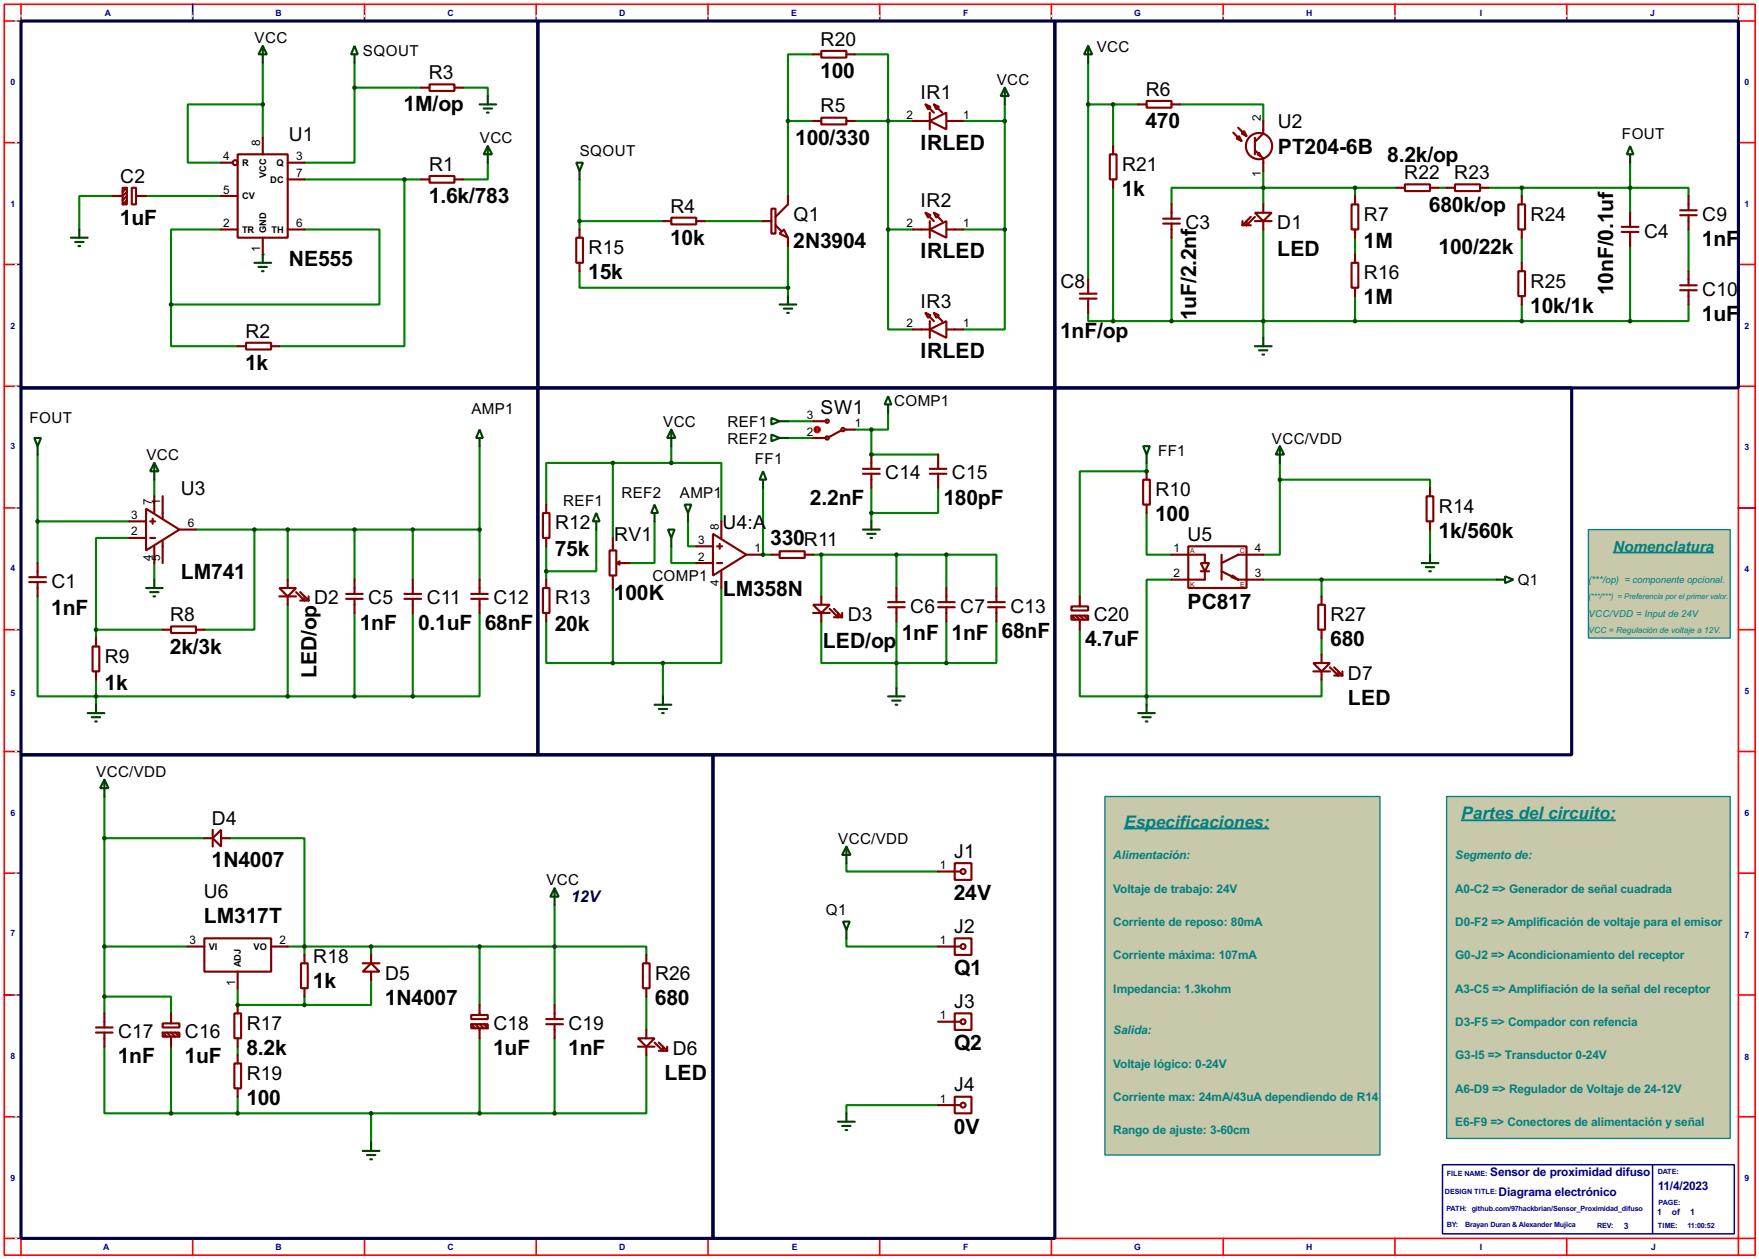
[picture p25: page 1]

(***/***) = Preferencia por el primer valor. VCC/VDD = Input de 24V

VCC = Regulación de voltaje a 12V.

A0-C2 => Generador de señal cuadrada

D0-F2 => Amplificación de voltaje para el emisor

A3-C5 => Amplifiación de la señal del receptor

A6-D9 => Regulador de Voltaje de 24-12V

Corriente max: 24mA/43uA dependiendo de R14

E6-F9 => Conectores de alimentación y señal

FILE NAME:
DESIGN TITLE:Diagrama electrónico

Sensor de proximidad difuso
