97hackbrian/Sensor_Proximidad_difuso/ButtonCopper.pdf

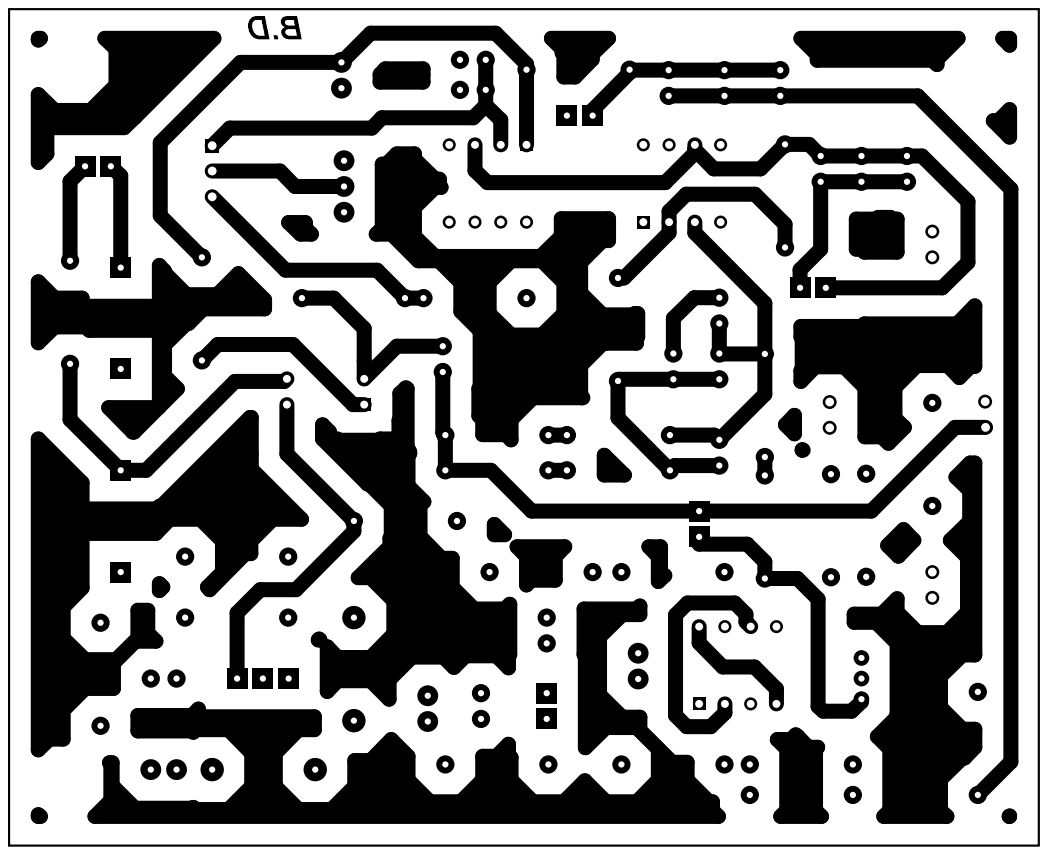
[picture p26: page 1]
