97hackbrian/Sensor_Proximidad_difuso/TopCooper.pdf

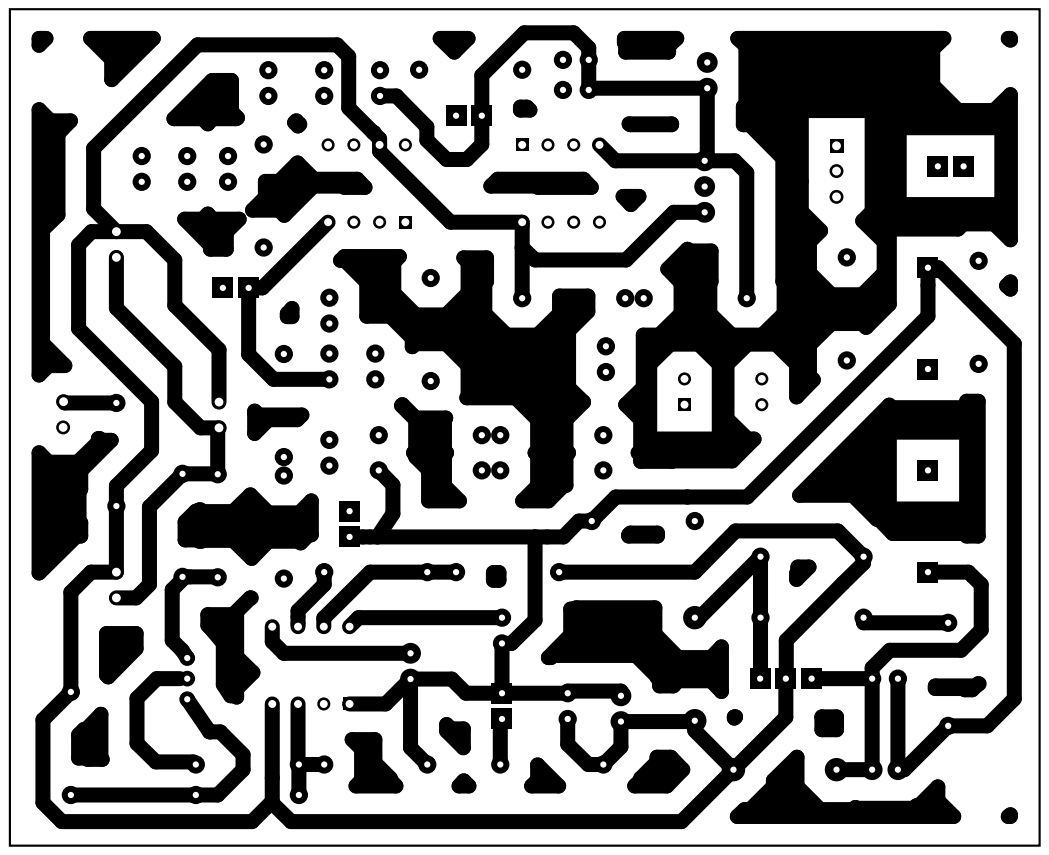
[picture p27: page 1]
