97hackbrian/Sensor_Proximidad_difuso/pcb.PDF

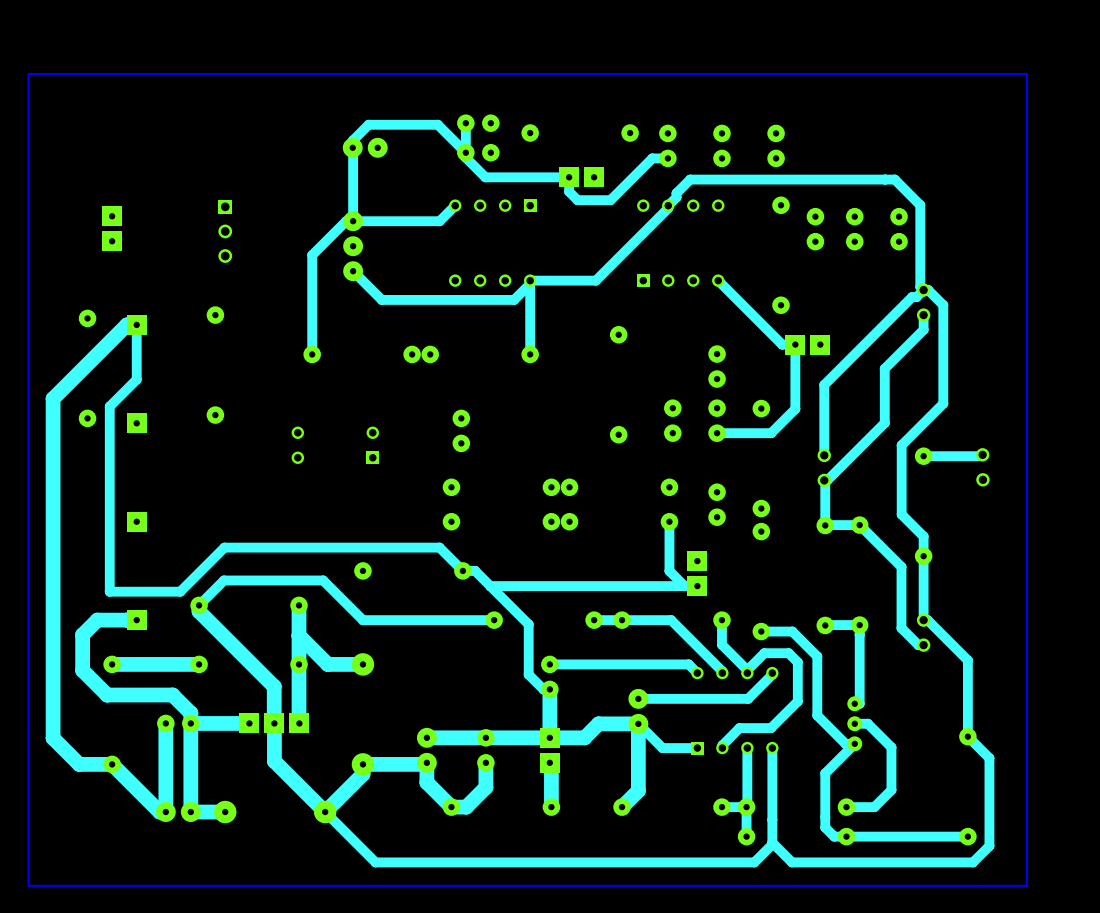
[picture p28: page 1]

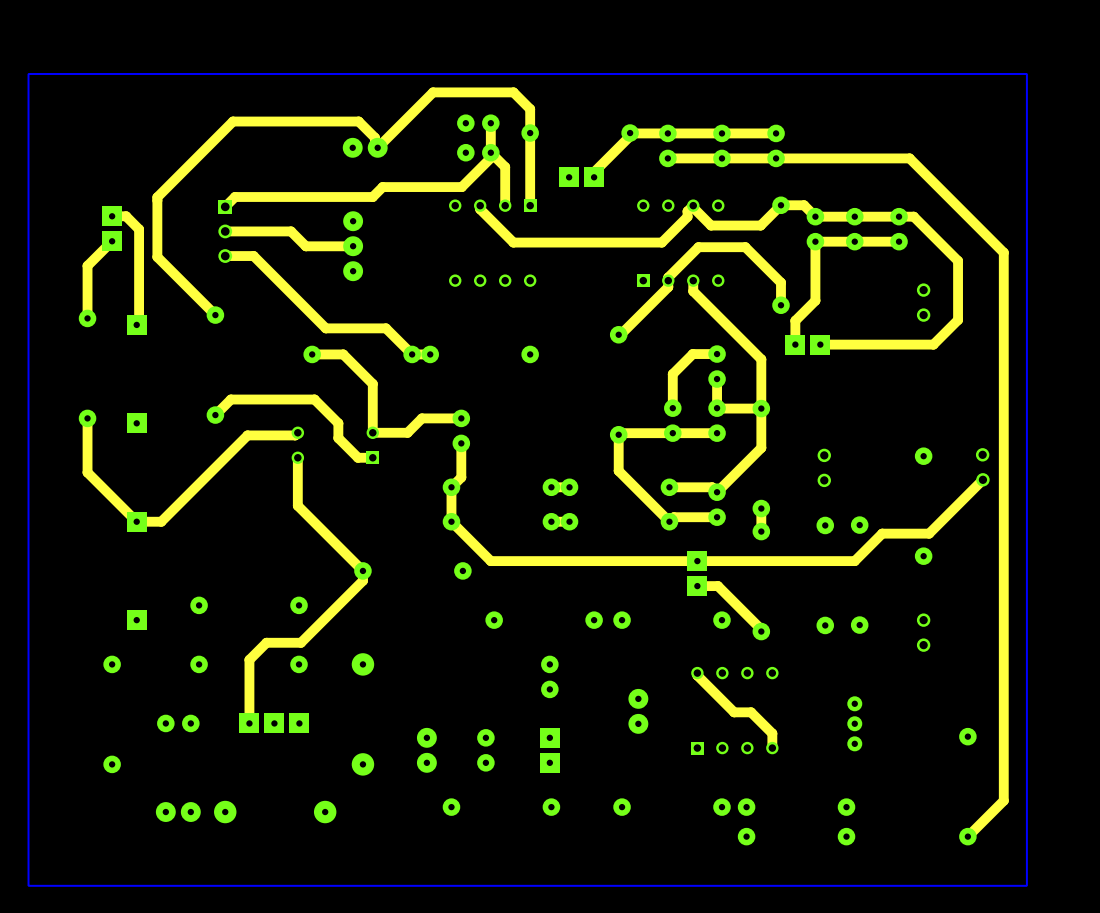
[picture p29: page 2]

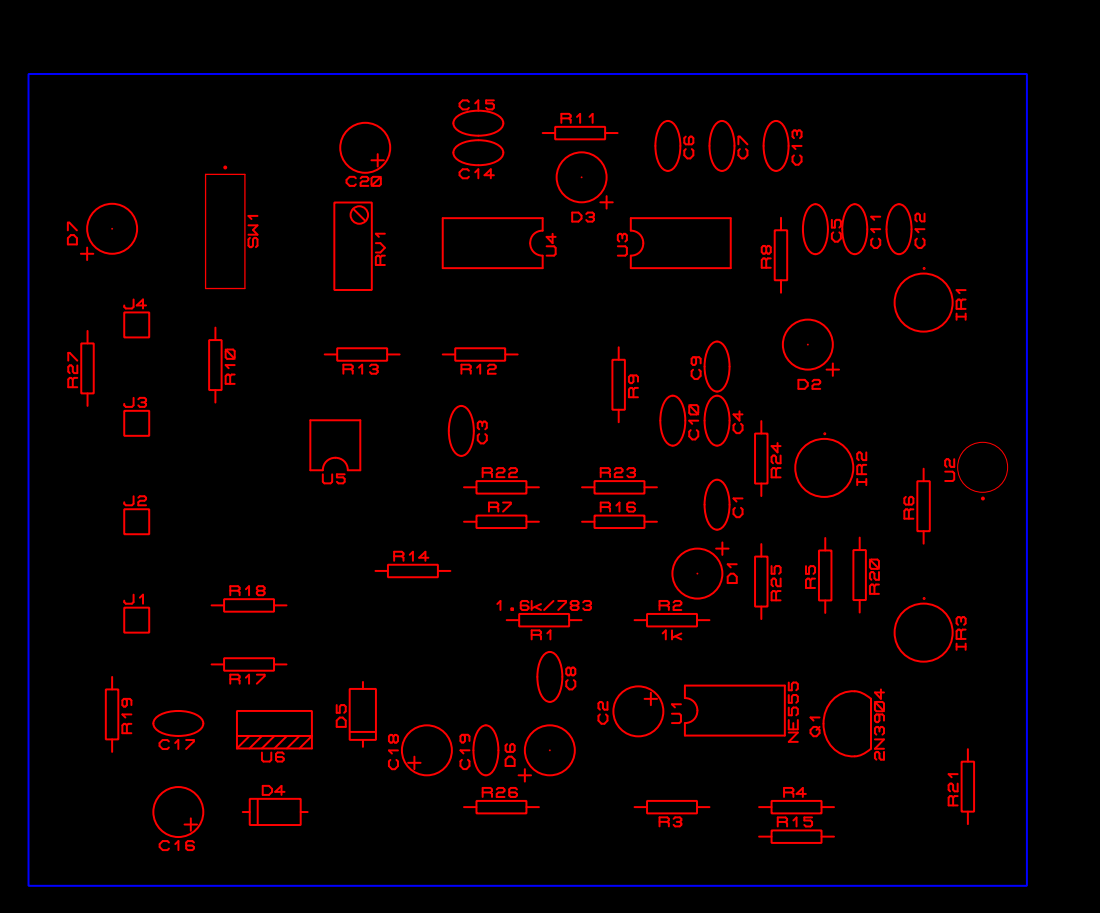
[picture p30: page 3]
