97hackbrian/Sensor_Proximidad_difuso/(list of files, drawings)

Other design files:
Diagrama_PCB_sensor_difuso.pdsprj
Project Backups/Diagrama_PCB_sensor_difuso [20230411, 00-35-31].pdsprj
Project Backups/Diagrama_PCB_sensor_difuso [20230411, 00-35-32].pdsprj
Project Backups/Diagrama_PCB_sensor_difuso [20230411, 00-35-52].pdsprj
Project Backups/Diagrama_PCB_sensor_difuso [20230411, 00-35-53].pdsprj
Project Backups/Diagrama_PCB_sensor_difuso [20230411, 00-36-33].pdsprj
Project Backups/Diagrama_PCB_sensor_difuso [20230411, 00-39-05].pdsprj
Project Backups/Diagrama_PCB_sensor_difuso [20230411, 10-57-37].pdsprj
Project Backups/Diagrama_PCB_sensor_difuso [20230411, 10-57-54].pdsprj
Project Backups/Diagrama_PCB_sensor_difuso [20230411, 11-00-51].pdsprj
Project Backups/Diagrama_PCB_sensor_difuso [20230423, 23-31-51].pdsprj
